Simply-Sara/PhobGCCv3-HW/README.md

# PhobGCCv3-HW
Seperate repository for the hardware used in the PhobGCC v3.0

The PhobGCC v3.0 board is licensed under CERN Open Hardware Licence Version 2 - Strongly Reciprocal.
This means that any changes made to the board should be made public and CHANGES.txt be updated to reflect said changes.
