Simply-Sara/PhobGCCv3-HW/PCB/KiCAD/PhobGCC_3_0_0_proto_1.kicad_pro.kicad_pcb

## KiCad design PCB/KiCAD/PhobGCC_3_0_0_proto_1.kicad_pro.kicad_pcb (2025-01-18)

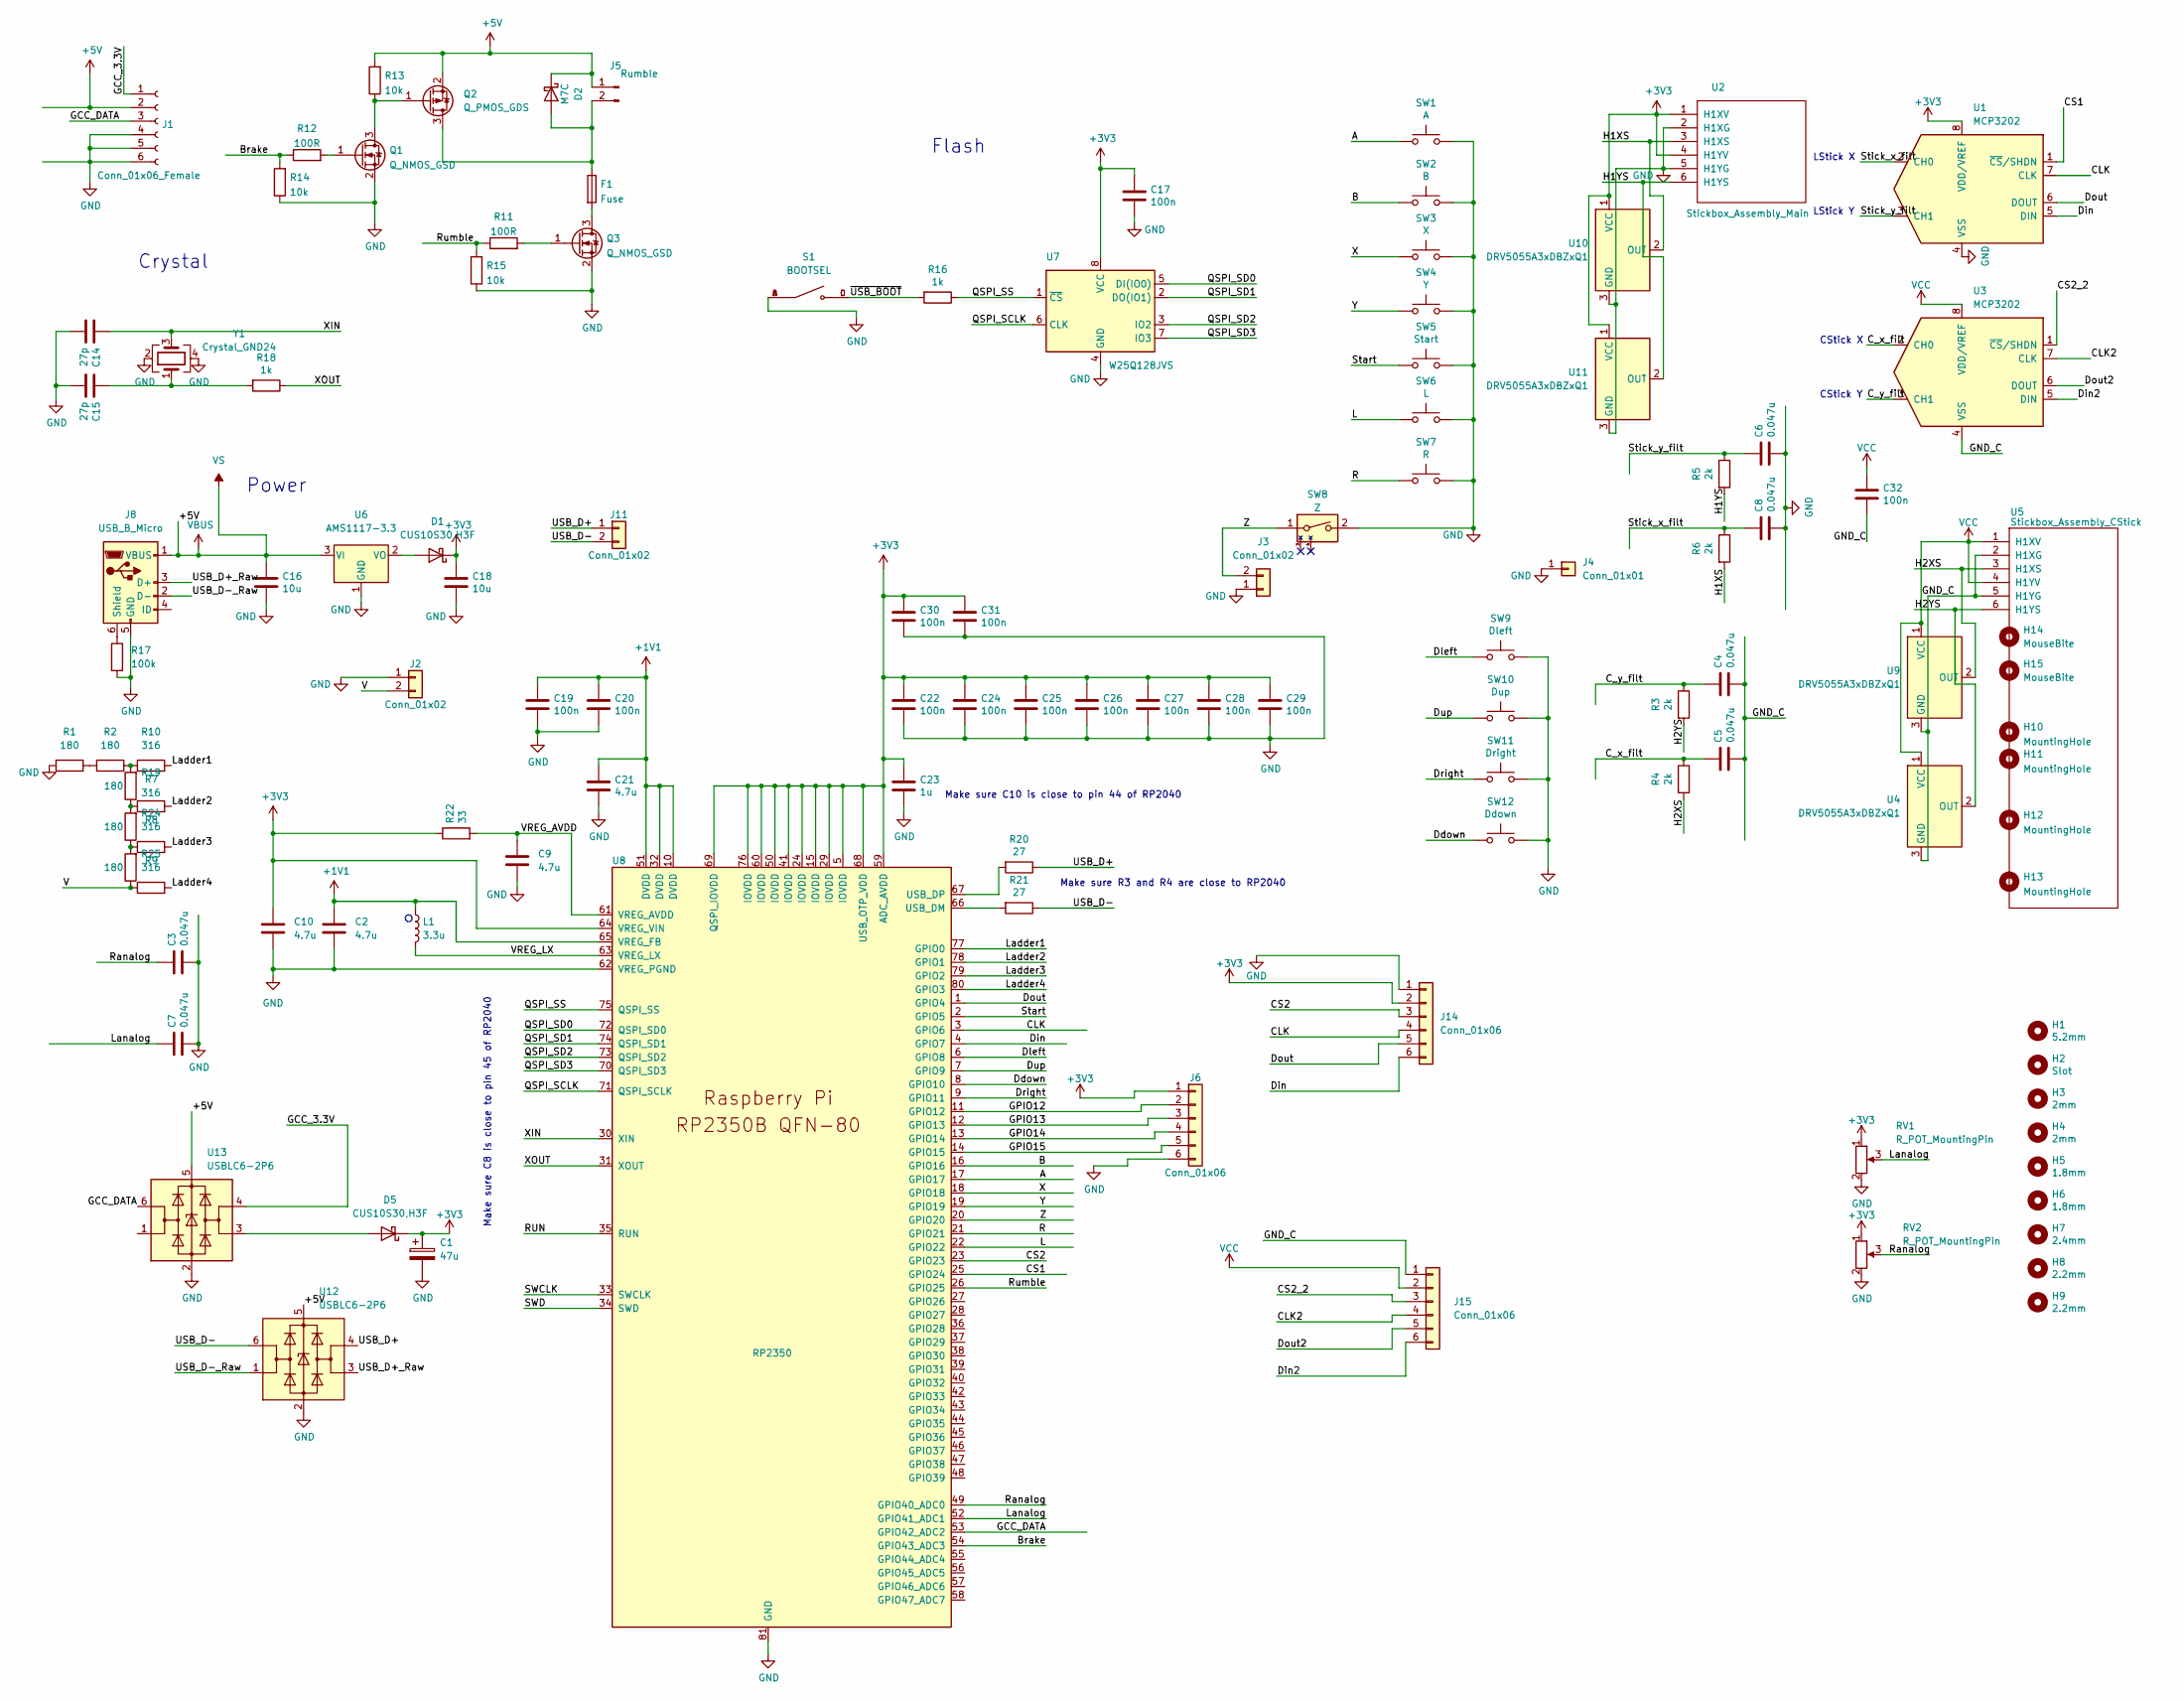
[picture p1: schematic PhobGCC_3_0_0_proto_1.kicad_pro.kicad_sch]

Parts:
C1: 47u; CP_EIA-3528-12_Kemet-T_Pad1.50x2.35mm_HandSolder; LCSC C136751
C2, C10: 4.7u; C_0402_1005Metric_small_pads
C3, C4, C5, C6, C7, C8: 0.047u; C_0603_HandSoldering; LCSC C1622
C9: 4.7u; C_0402_1005Metric
C14, C15: 27p; C_0402_1005Metric; LCSC C1557
C16, C18: 10u; C_0805_2012Metric; LCSC C15850
C17, C19, C20, C22, C24, C25, C26, C27, C28, C29, C30, C31, C32: 100n; C_0402_1005Metric; LCSC C1525
C21: 4.7u; C_0402_1005Metric; LCSC C52923
C23: 1u; C_0402_1005Metric; LCSC C52923
D1, D5: CUS10S30,H3F; D_SOD-323; LCSC C146335
D2: M7C; D_SOD-123; LCSC C8598
F1: Fuse; Fuse_1206_3216Metric; LCSC C69680
H1: 5.2mm; MountingHole_5.2mm
H2: Slot
H3, H4: 2mm; MountingHole_2.0mm
H5, H6: 1.8mm; MountingHole_1.8mm
H7: 2.4mm; MountingHole_2.4mm
H8, H9: 2.2mm; MountingHole_2.2mm
H10: MountingHole; MountingHole_1.8mm
H11: MountingHole; MountingHole_5.2mm
H12, H13: MountingHole; MountingHole_2.0mm
H14: MouseBite; breakaway-mousebites-double-v2-small
H15: MouseBite; breakaway-mousebites-double-v2-large
J1: Conn_01x06_Female; GCC_Header_Straight_1x06_Pitch2.00mm
J2, J11: Conn_01x02; PinHeader_1x02_P2.00mm_Vertical
J3: Conn_01x02; PinHeader_1x02_P2.00mm_Horizontal
J4: Conn_01x01; PinHeader_1x01_P2.54mm_Vertical
J5: Rumble; rumble_pins
J6, J14, J15: Conn_01x06; PinSocket_1x06_P2.00mm_Vertical
J8: USB_B_Micro; USB_Micro-B_Amphenol_10118194_Horizontal; LCSC C132563
L1: 3.3u; L_pol_2016
Q1, Q3: Q_NMOS_GSD; SOT-23; LCSC C20917
Q2: Q_PMOS_GDS; SOT-23; LCSC C15127
R1, R2, R7, R8, R9: 180; R_0402_1005Metric; LCSC C38941
R3, R4, R5, R6: 2k; R_0603_1608Metric_Pad0.98x0.95mm_HandSolder; LCSC C22975
R10, R19, R24, R25: 316; R_0402_1005Metric; LCSC C159037
R11, R12: 100R; R_0603_1608Metric_Pad0.98x0.95mm_HandSolder; LCSC C22775
R13, R14, R15: 10k; R_0603_1608Metric_Pad0.98x0.95mm_HandSolder; LCSC C25804
R16, R18: 1k; C_0402_1005Metric; LCSC C11702
R17: 100k; R_0603_1608Metric_Pad0.98x0.95mm_HandSolder; LCSC C25803
R20, R21: 27; C_0402_1005Metric; LCSC C25100
R22: 33; R_0402_1005Metric
RV1, RV2: R_POT_MountingPin; GCC_Slider
S1: BOOTSEL; SW_TS-1187A-B-A-B; PARTREV A0
SW1: A; ABXY_Contact_Omron_Switch_Circley
SW2: B; ABXY_Contact_Omron_Switch_Circley
SW3: X; ABXY_Contact_Omron_Switch_Circley
SW4: Y; ABXY_Contact_Omron_Switch_Circley
SW5: Start; Start_Contact
SW6: L; Pin_Header_Straight_1x02_Pitch2.54mm
SW7: R; Pin_Header_Straight_1x02_Pitch2.54mm
SW8: Z; Z_Switch_Edge_Omron
SW9: Dleft; Dpad_Contact_TL3315NF_2_ZigZag
SW10: Dup; Dpad_Contact_TL3315NF_2_ZigZag
SW11: Dright; Dpad_Contact_TL3315NF_2_ZigZag
SW12: Ddown; Dpad_Contact_TL3315NF_2_ZigZag
U1, U3: MCP3202; SOIC-8_3.9x4.9mm_P1.27mm; LCSC C56997
U2: Stickbox_Assembly_Main; GCC_Stickbox_Hall_Only
U4, U9, U10, U11: DRV5055A3xDBZxQ1; SOT-23; LCSC C266128
U5: Stickbox_Assembly_CStick; GCC_Stickbox_Hall_Only
U6: AMS1117-3.3; SOT-223-3_TabPin2; LCSC C6186
U7: W25Q128JVS; SOIC-8_5.23x5.23mm_P1.27mm; LCSC C97521
U8: RP2350; RP2350-QFN-80-1EP_10x10_P0.4mm_EP3.4x3.4mm_ThermalVias; LCSC C2040
U12, U13: USBLC6-2P6; SOT-666; LCSC C2827693
Y1: Crystal_GND24; Crystal_SMD_3225-4Pin_3.2x2.5mm; LCSC C40395

Connections:
+1V1: C2.1, C19.1, C20.1, C21.1, L1.1, U8.10 (DVDD), U8.32 (DVDD), U8.51 (DVDD), U8.65 (VREG_FB)
+3V3: C1.1, C10.1, C17.1, C18.1, C22.1, C23.1, C24.1, C25.1, C26.1, C27.1, C28.1, C29.1, C30.1, C31.1, D1.1 (K), D5.1 (K), J6.1, J14.2, R22.1, RV1.1 (V+), RV2.1 (V+), U1.8 (VDD/VREF), U2.1 (H1XV), U2.4 (H1YV), U7.8 (VCC), U8.5 (IOVDD), U8.15 (IOVDD), U8.24 (IOVDD), U8.29 (IOVDD), U8.41 (IOVDD), U8.50 (IOVDD), U8.59 (ADC_AVDD), U8.60 (IOVDD), U8.64 (VREG_VIN), U8.68 (USB_OTP_VDD), U8.69 (QSPI_IOVDD), U8.76 (IOVDD), U10.1 (VCC), U11.1 (VCC)
+5V: C16.1, D2.1 (K), J1.2, J5.1, J8.1 (VBUS), Q2.2 (S), R13.2, U6.3 (VI), U12.5 (VBUS), U13.5 (VBUS)
/A: SW1.1, U8.17 (GPIO17)
/B: SW2.1, U8.16 (GPIO16)
/Brake: R12.1, R14.2, U8.54 (GPIO43_ADC3)
/CLK: J14.4, U1.7 (CLK), U8.3 (GPIO6)
/CLK2: J15.4, U3.7 (CLK)
/CS1: U1.1 (~CS/SHDN), U8.25 (GPIO24)
/CS2: J14.3, U8.23 (GPIO23)
/CS2_2: J15.3, U3.1 (~CS/SHDN)
/C_x_filt: C5.1, R4.1, U3.2 (CH0)
/C_y_filt: C4.1, R3.1, U3.3 (CH1)
/Ddown: SW12.1, U8.8 (GPIO10)
/Din: J14.6, U1.5 (DIN), U8.4 (GPIO7)
/Din2: J15.6, U3.5 (DIN)
/Dleft: SW9.1, U8.6 (GPIO8)
/Dout: J14.5, U1.6 (DOUT), U8.1 (GPIO4)
/Dout2: J15.5, U3.6 (DOUT)
/Dright: SW11.1, U8.9 (GPIO11)
/Dup: SW10.1, U8.7 (GPIO9)
/GCC_3.3V: J1.1, U13.4 (I/O2)
/GCC_DATA: J1.3, U8.53 (GPIO42_ADC2), U13.6 (I/O1)
/GND_C: C4.2, C5.2, C32.2, J15.1, U3.4 (VSS), U4.3 (GND), U5.2 (H1XG), U5.5 (H1YG), U9.3 (GND)
/GPIO12: J6.2, U8.11 (GPIO12)
/GPIO13: J6.3, U8.12 (GPIO13)
/GPIO14: J6.4, U8.13 (GPIO14)
/GPIO15: J6.5, U8.14 (GPIO15)
/H1XS: R6.2, U2.3 (H1XS), U10.2 (OUT)
/H1YS: R5.2, U2.6 (H1YS), U11.2 (OUT)
/H2XS: R4.2, U5.3 (H1XS), U9.2 (OUT)
/H2YS: R3.2, U4.2 (OUT), U5.6 (H1YS)
/L: SW6.1, U8.22 (GPIO22)
/Ladder1: R10.2, U8.77 (GPIO0)
/Ladder2: R19.2, U8.78 (GPIO1)
/Ladder3: R24.2, U8.79 (GPIO2)
/Ladder4: R25.2, U8.80 (GPIO3)
/Lanalog: C7.1, RV1.3 (Signal), U8.52 (GPIO41_ADC1)
/QSPI_SCLK: U7.6 (CLK), U8.71 (QSPI_SCLK)
/QSPI_SD0: U7.5 (DI(IO0)), U8.72 (QSPI_SD0)
/QSPI_SD1: U7.2 (DO(IO1)), U8.74 (QSPI_SD1)
/QSPI_SD2: U7.3 (IO2), U8.73 (QSPI_SD2)
/QSPI_SD3: U7.7 (IO3), U8.70 (QSPI_SD3)
/QSPI_SS: R16.1, U7.1 (~CS), U8.75 (QSPI_SS)
/R: SW7.1, U8.21 (GPIO21)
/RUN: U8.35 (RUN)
/Ranalog: C3.1, RV2.3 (Signal), U8.49 (GPIO40_ADC0)
/Rumble: R11.1, R15.2, U8.26 (GPIO25)
/SWCLK: U8.33 (SWCLK)
/SWD: U8.34 (SWD)
/Start: SW5.1, U8.2 (GPIO5)
/Stick_x_filt: C8.1, R6.1, U1.2 (CH0)
/Stick_y_filt: C6.1, R5.1, U1.3 (CH1)
/USB_D+: J11.1, R20.1, U12.4 (I/O2)
/USB_D+_Raw: J8.3 (D+), U12.3 (I/O2)
/USB_D-: J11.2, R21.1, U12.6 (I/O1)
/USB_D-_Raw: J8.2 (D-), U12.1 (I/O1)
/V: J2.2, R9.1, R25.1
/VREG_AVDD: C9.1, R22.2, U8.61 (VREG_AVDD)
/VREG_LX: L1.2, U8.63 (VREG_LX)
/X: SW3.1, U8.18 (GPIO18)
/XIN: C14.1, U8.30 (XIN), Y1.3
/XOUT: R18.1, U8.31 (XOUT)
/Y: SW4.1, U8.19 (GPIO19)
/Z: J3.2, SW8.1, U8.20 (GPIO20)
/~USB_BOOT: R16.2, S1.C, S1.D
GND: C1.2, C2.2, C3.2, C6.2, C7.2, C8.2, C9.2, C10.2, C14.2, C15.2, C16.2, C17.2, C18.2, C19.2, C20.2, C21.2, C22.2, C23.2, C24.2, C25.2, C26.2, C27.2, C28.2, C29.2, C30.2, C31.2, J1.4, J1.5, J1.6, J2.1, J3.1, J4.1, J6.6, J8.5 (GND), J14.1, Q1.2 (S), Q3.2 (S), R1.2, R14.1, R15.1, R17.2, RV1.2 (GND), RV2.2 (GND), S1.A, S1.B, SW1.2, SW2.2, SW3.2, SW4.2, SW5.2, SW6.2, SW7.2, SW8.2, SW9.2, SW10.2, SW11.2, SW12.2, U1.4 (VSS), U2.2 (H1XG), U2.5 (H1YG), U6.1 (GND), U7.4 (GND), U8.62 (VREG_PGND), U8.81 (GND), U10.3 (GND), U11.3 (GND), U12.2 (GND), U13.2 (GND), Y1.2, Y1.4
unnamed: C15.1, R18.2, Y1.1
unnamed: D1.2 (A), U6.2 (VO)
unnamed: D2.2 (A), F1.1, J5.2, Q2.3 (D)
unnamed: D5.2 (A), U13.3 (I/O2)
unnamed: J8.6 (Shield), R17.1
unnamed: Q1.3 (D), Q2.1 (G), R13.1
unnamed: Q1.1 (G), R12.2
unnamed: F1.2, Q3.3 (D)
unnamed: Q3.1 (G), R11.2
unnamed: R1.1, R2.2
unnamed: R2.1, R7.2, R10.1
unnamed: R7.1, R8.2, R19.1
unnamed: R8.1, R9.2, R24.1
unnamed: R21.2, U8.66 (USB_DM)
unnamed: R20.2, U8.67 (USB_DP)
VCC: C32.1, J15.2, U3.8 (VDD/VREF), U4.1 (VCC), U5.1 (H1XV), U5.4 (H1YV), U9.1 (VCC)

Notes on the sheet:
Power
LStick Y
Make sure C10 is close to pin 44 of RP2040
CStick Y
Make sure R3 and R4 are close to RP2040
Make sure C8 is close to pin 45 of RP2040
Flash
Crystal
CStick X
LStick X

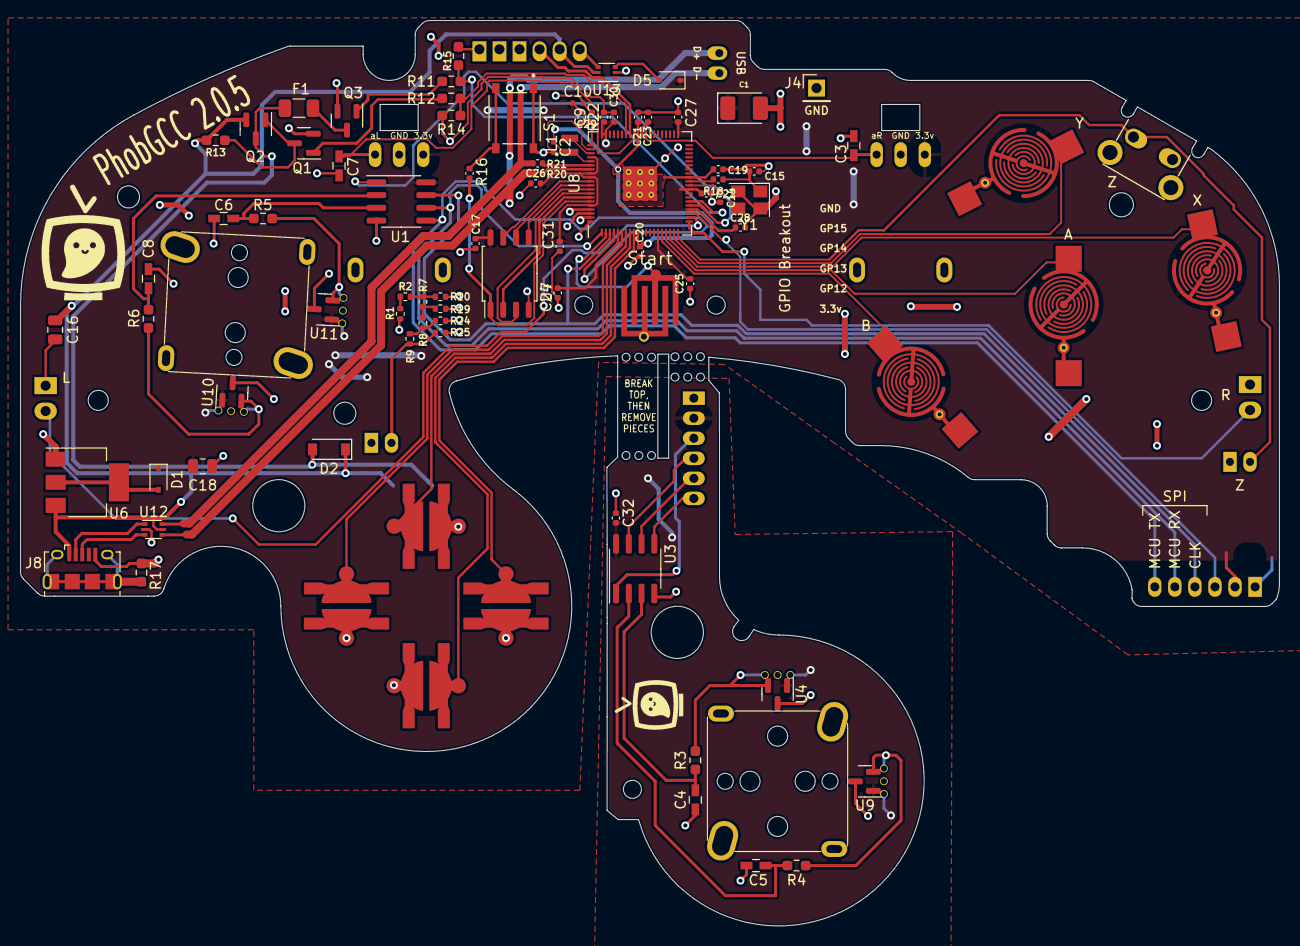
[picture p2: board PhobGCC_3_0_0_proto_1.kicad_pro.kicad_pcb from above]

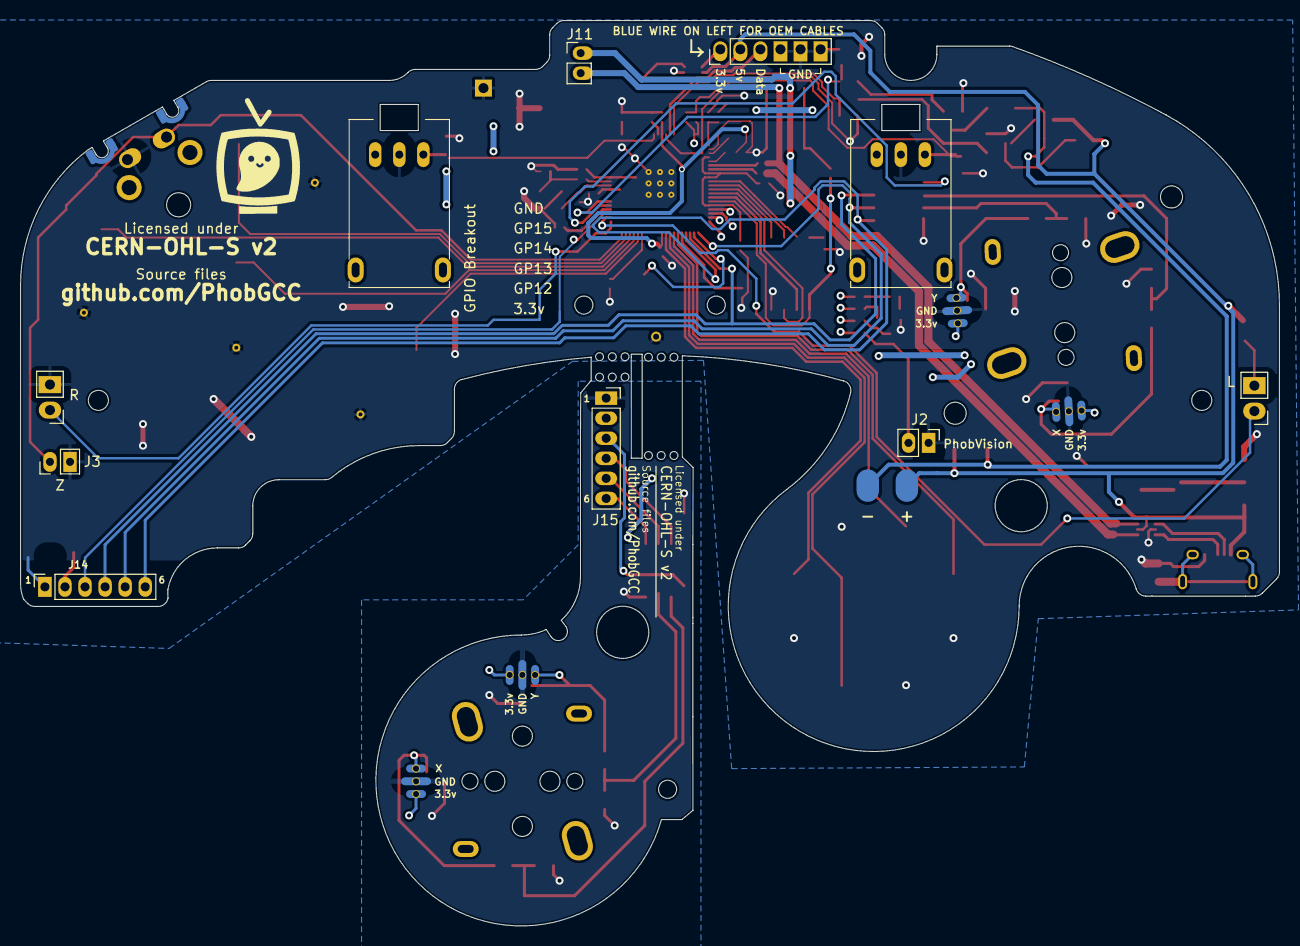
[picture p3: board PhobGCC_3_0_0_proto_1.kicad_pro.kicad_pcb from below]

Board: 4 copper layers, 125.5 x 90.3 mm, 117 parts (12 on the bottom side), 76 nets.

Other parts of the board:
Gphobtvbigback: LOGO; phobtv_bold_big
Gphobtvbigback#2: LOGO; phobtv_bold_big
Gtvsmallfrontc: LOGO; phobtv_bold_smol
