Simply-Sara/PhobGCCv3-HW/(commit log)

2025-01-17 Updated Kicad file names to V3
    [PhobGCC_2_0_0_proto_1.kicad_sch, PhobGCC_3_0_0_proto_1.kicad_pro.kicad_pcb, PhobGCC_3_0_0_proto_1.kicad_pro.kicad_sch]
2025-01-18 RP2040 to RP2350 Conversion
    [PhobGCC_3_0_0_proto_1.kicad_pro.kicad_pcb, PhobGCC_3_0_0_proto_1.kicad_pro.kicad_sch]
