Simply-Sara/PhobGCCv3-HW/(notices)

Notices in the files:
PCB/KiCAD/PhobGCC_3_0_0_proto_1.kicad_pro.kicad_pcb:
CERN-OHL-S v2
